rejamison/iphone_x_stand/README.md

# iphone_x_stand

I wanted a tidy wireless charging solution for my iPhone X and Apple Watch Series 2 so created this stand.

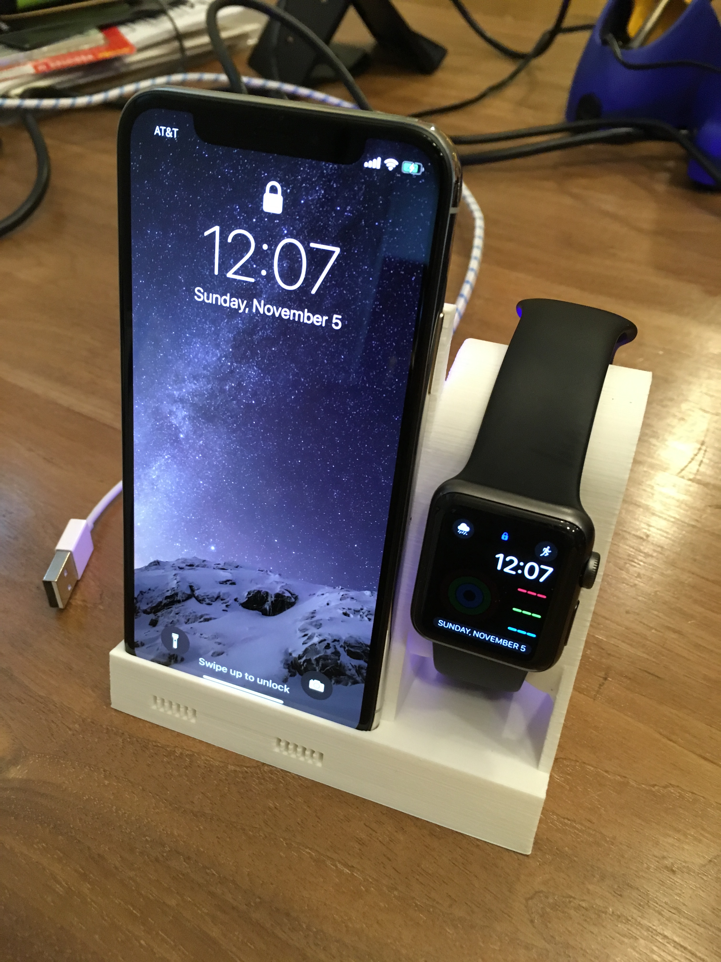
[picture p1: front_assembled.jpg]


## 3D Printing

|Part|Count|Material|Print Time|Supports|
|---|---|---|---|---|
|[charging_stand.stl](charging_stand.stl)|x1|88g|14 hours|No|
|**Total**| |**88g**|**14 hours**| |

* Printed on Ultimaker 2+ with Polymaker PolyMax PLA.
* 0.15mm layer height.
* Some stringing on overhangs in the back without supports, I don't mind it since out of sight, out of mind.
* You can use [charging_stand_no_watch.stl](charging_stand_no_watch.stl) if you don't need the watch stand.  Reduces print time to 7 hours and only uses 50g of material.

## Assembly

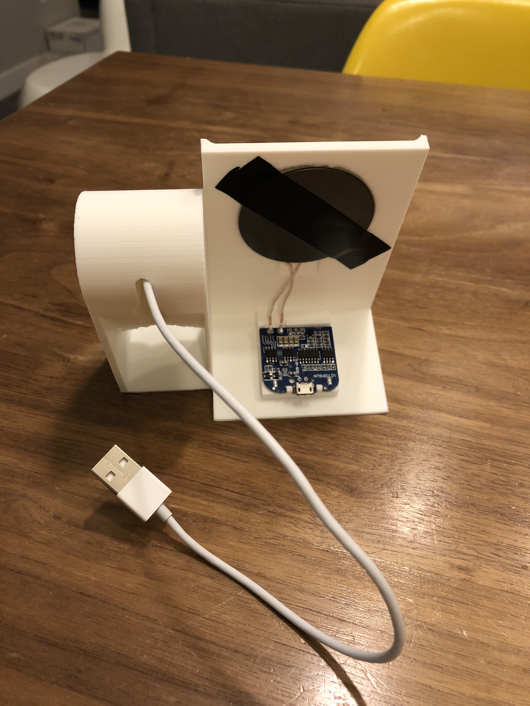
[picture p2: rear_assembled.jpg]


1. Fit the Gikfun Qi wire coil, wire side facing the phone, into the back of the stand.  I needed to secure it with a bit of electrical tape.
1. Fit the Gikfun Qi PCB into the studs on the base of the stand.  It should friction fit.
1. Pull the USB cable of the OPSO Apple Watch charger through the hole in the watch stand.  Orient the cable upwards into the channel cut for it, then press the charging base into the hole.  It may take a bit of force to pop in.
1. Plugin a micro-USB cable to the Gikfun Qi and plugin the apple watch charger.
1. (Optional) The LEDs on the Gikfun is quite bright, so you may want to cover them up with a bit of Sugru or Liquid Electrical Tape.
1. Enjoy!

## Bill of Materials

|Basic Tools & Materials|
|---|
|Black Sugru or Liquid Electrical Tape (Optional)|
|Micro-USB Cable|

|Item|Count|Unit Price|Total|Link|Notes|
|---|---|---|---|---|---|
|Gikfun Qi Wireless Charger PCB|1|$9|$9|[Amazon](https://www.amazon.com/gp/product/B073W7P5T8/ref=oh_aui_detailpage_o03_s00?ie=UTF8&psc=1)||
|OPSO Apple Watch Charger|1|$26|$26|[Amazon](https://www.amazon.com/gp/product/B01MXX9IIY/ref=oh_aui_detailpage_o03_s00?ie=UTF8&psc=1)||
|**Total**| | |**$35**|||

## Potential Improvements

* I think both chargers use less than 2.5amps.  They could be tied together so only one cord is needed.
