rejamison/iphone_x_stand/charging_stand_no_watch.stl

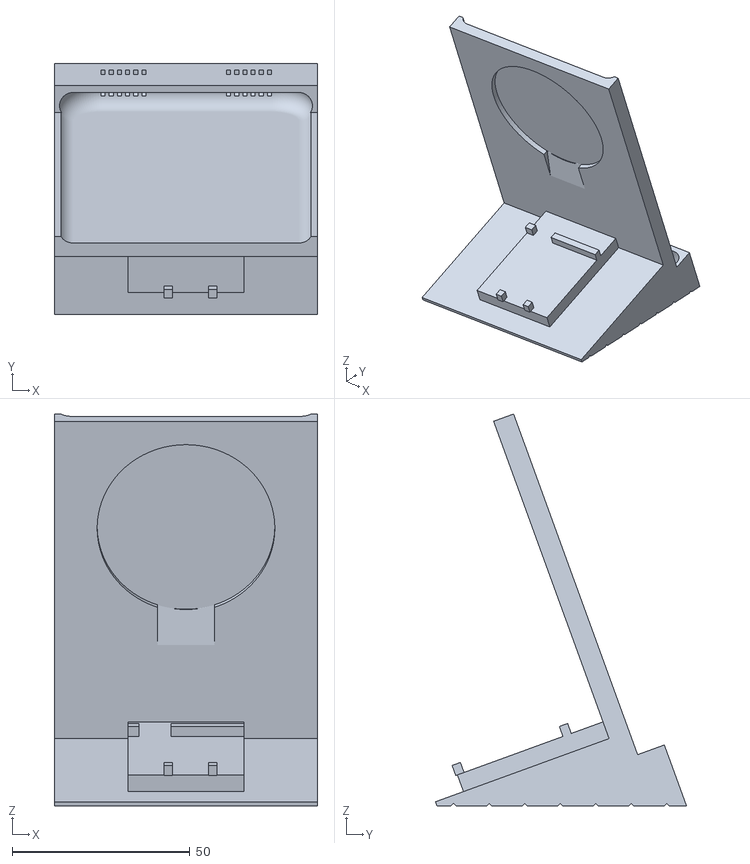
[picture p3: CAD file, 2017-11-05]
charging_stand_no_watch.stl
74.0 x 70.7 x 110.3
