rejamison/iphone_x_stand/charging_stand.stl

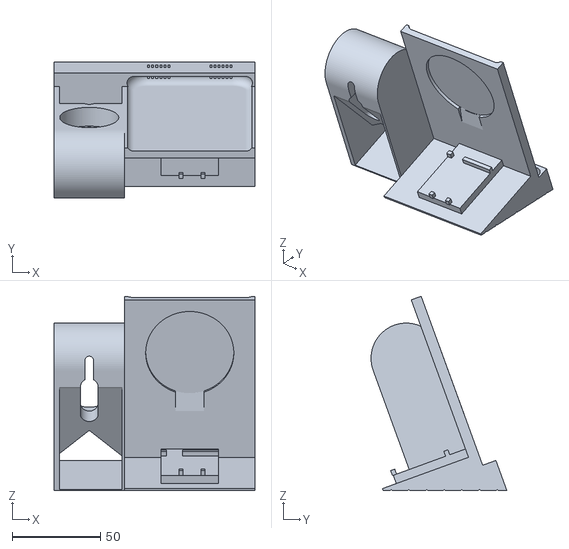
[picture p4: CAD file, 2017-11-05]
charging_stand.stl
114.0 x 77.1 x 110.3
