rejamison/iphone_x_stand/front_unassembled.jpg

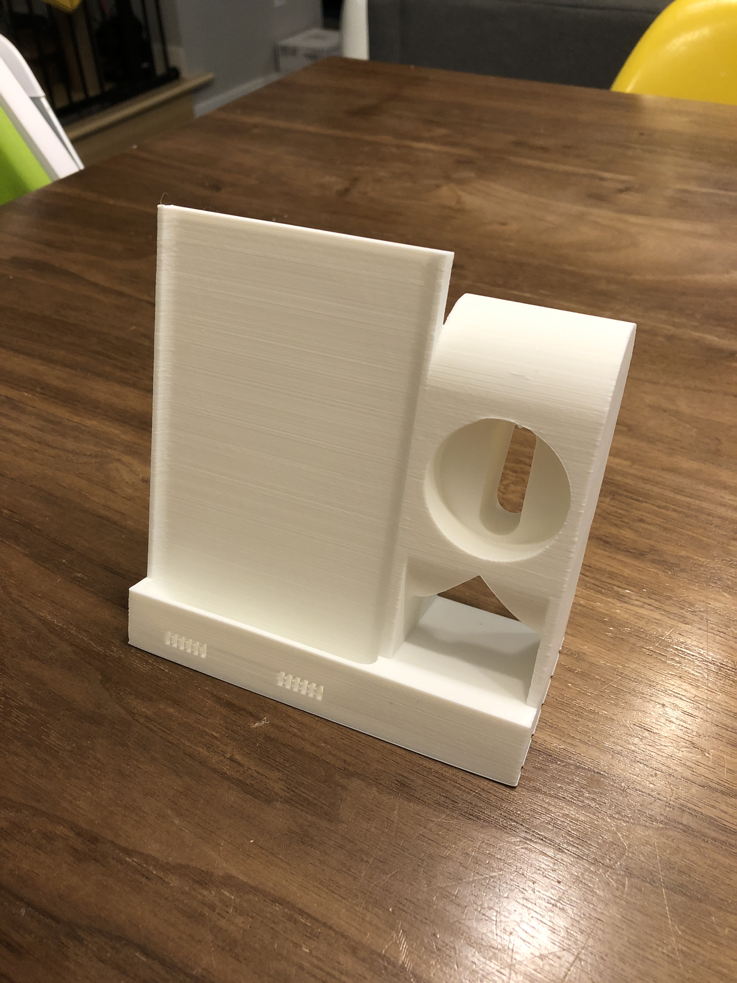
front_unassembled.jpg
