rejamison/iphone_x_stand/rear_unassembled.jpg

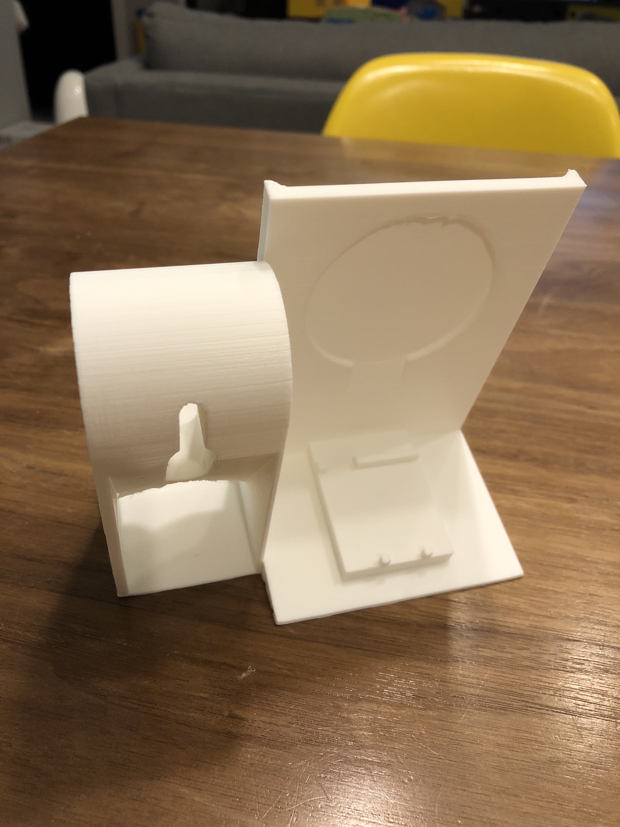
rear_unassembled.jpg
